dk2jk/ctcss/README.md

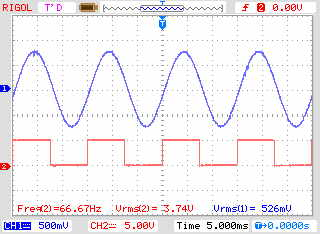
[picture p1: scope.jpg]
bild


# CTCSS - Tongenerator
als Update für ältere HAM-Radio VHF/UHF- Geräte.
Hardware: Arduino Mini-Pro ( 8 MHz / 3.3V ) 
Methode: Direkte Digitalen Synthese ( DDS )

# Ordner 'TS-811':
Es wird ein Selbstbau CTCSS-Modul zum Nachrüsten  in einen TS-811- Transceiver beschrieben, realisiert mit einem Arduino-Nano- Modul. Dabei wird die Direkte Digital Synthese  (DDS) verwendet.
