dk2jk/ctcss/SinusGeneratorArduino-0520.pdf

### Arduino Sinus-Generator nach der Direkten Digitalen Synthese ( DDS )

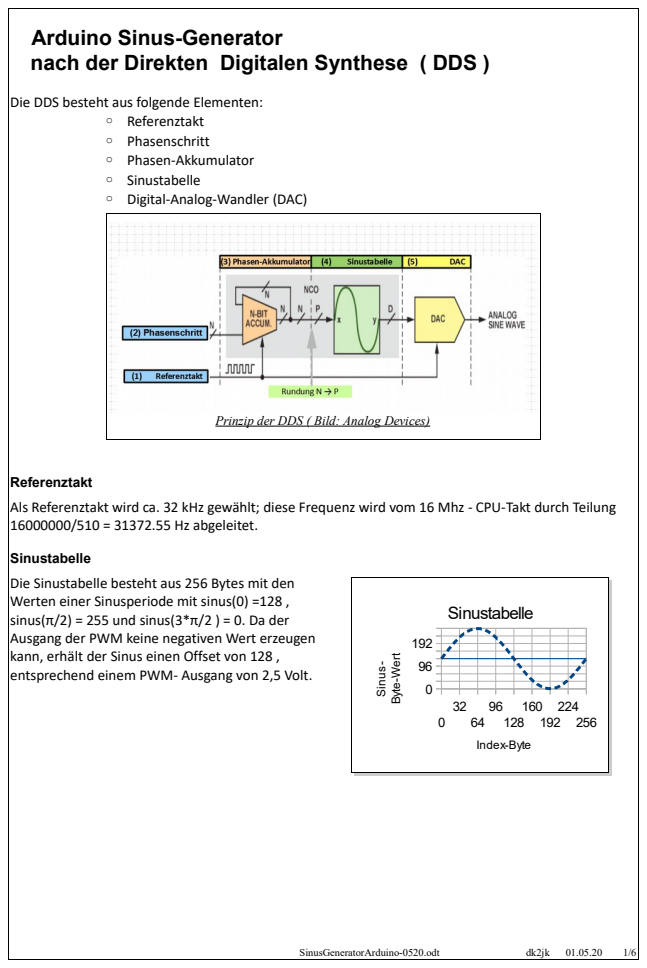
[picture p2: page 1]
SinusGeneratorArduino-0520.odt; Sinustabelle; Index-Byte; Sinus-; Byte-Wert

Die DDS besteht aus folgende Elementen:

◦ Referenztakt
◦ Phasenschritt
◦ Phasen-Akkumulator
◦ Sinustabelle
◦ Digital-Analog-Wandler (DAC)

Prinzip der DDS ( Bild: Analog Devices)

Referenztakt
Als Referenztakt wird ca. 32 kHz gewählt; diese Frequenz wird vom 16 Mhz - CPU-Takt durch Teilung
16000000/510 = 31372.55 Hz abgeleitet.

Sinustabelle
Die Sinustabelle besteht aus 256 Bytes mit den
Werten einer Sinusperiode mit sinus(0) =128 ,
sinus(π/2) = 255 und sinus(3*π/2 ) = 0. Da der
Ausgang der PWM keine negativen Wert erzeugen
kann, erhält der Sinus einen Offset von 128 ,
entsprechend einem PWM- Ausgang von 2,5 Volt.

Phasen-Akkumulator
Im Phasen-Akkumulator wird bei jedem Takt ein Phasenschritt-Wert aufaddiert. Die Phase wird dargestellt durch eine Zahl von 0 … 2**32-1 ( 32 Bit ). Das entspricht einem Datentyp 'unsigned long' .

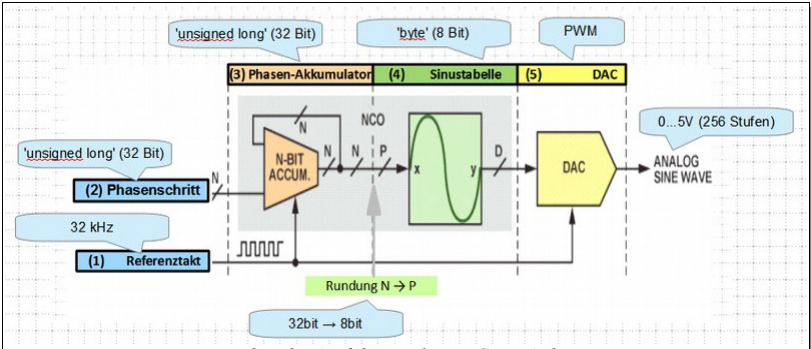
[picture p3: figure]

Wertezuordnung:
Phasen-Akkumulator N | Index in der Sinustabelle P | Grad | Winkel | sin(Winkel) | Ausgang D
0x00000000 | 0 | 0 | 0 | 0 | 127
0x40000000 | 64 | 90 | 0.5*pi | 1 | 255
0x80000000 | 128 | 180 | pi | 0 | 127
0xc0000000 | 192 | 270 | 1.5 *pi | -1 | 0
0xFFFFFFFF | 255 | <360 | <2*pi | <0 | <127
0x00000000 | 0 | 360 | 2*pi | 0 | 127

Die obersten 8 Bits (grau markiert) werden als Index in der Sinus-Tabelle verwendet( 0x00 = 1. Wert in der Tabelle , 0xFF= letzter Wert in der Tabelle ). Diese Rundung betrifft nur die Sinustabelle, der Phasen-Akkumulator behält seine 32-Bit-Auflösung.
Beim Überlauf des Phasen-Akkumulators von 0xFFFFFFFF auf 0x00000000 ergibt sich automatisch ein Sprung zum Beginn der Sinustabelle.
Mit dem Phasenschritt wird die Frequenz eingestellt: kleine Werte ergeben niedrige Frequenz , große Werte hohe Frequenz.
Es gilt folgende Formel:
f = ( Phasenschritt * Taktfrequenz ) / 2**32 Taktfrequenz = 31372.55 Hz
f = ( Phasenschritt* 31372.55 ) / 2**32

Aufgelöst nach Phasenschritt: Phasenschritt= 2**32* f / 31372.55)

SinusGeneratorArduino-0520.odt | dk2jk | 01.05.20 | 2/6

Praktische Ausführung der DDS mit Arduino

Anschauliche Darstellung
Das 'Digital Phase Wheel' demonstriert die Generierung des Sinus mit der DDS- Methode:

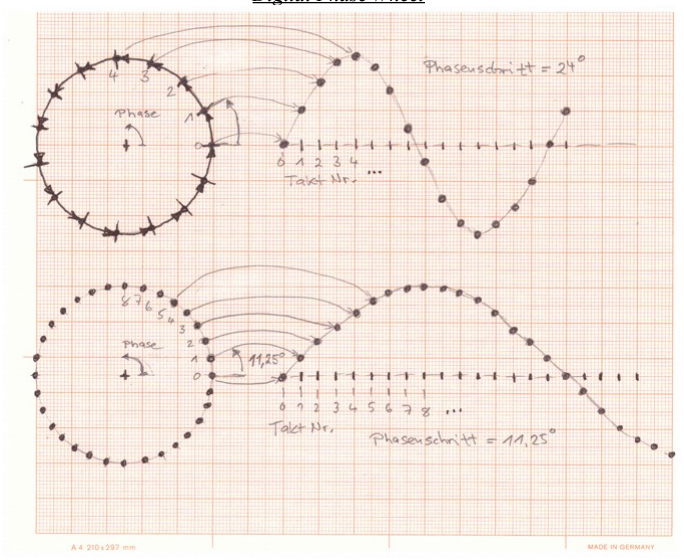
[picture p4: figure]

SinusGeneratorArduino-0520.odt | dk2jk | 01.05.20 | 3/6

Digital Phase Wheel

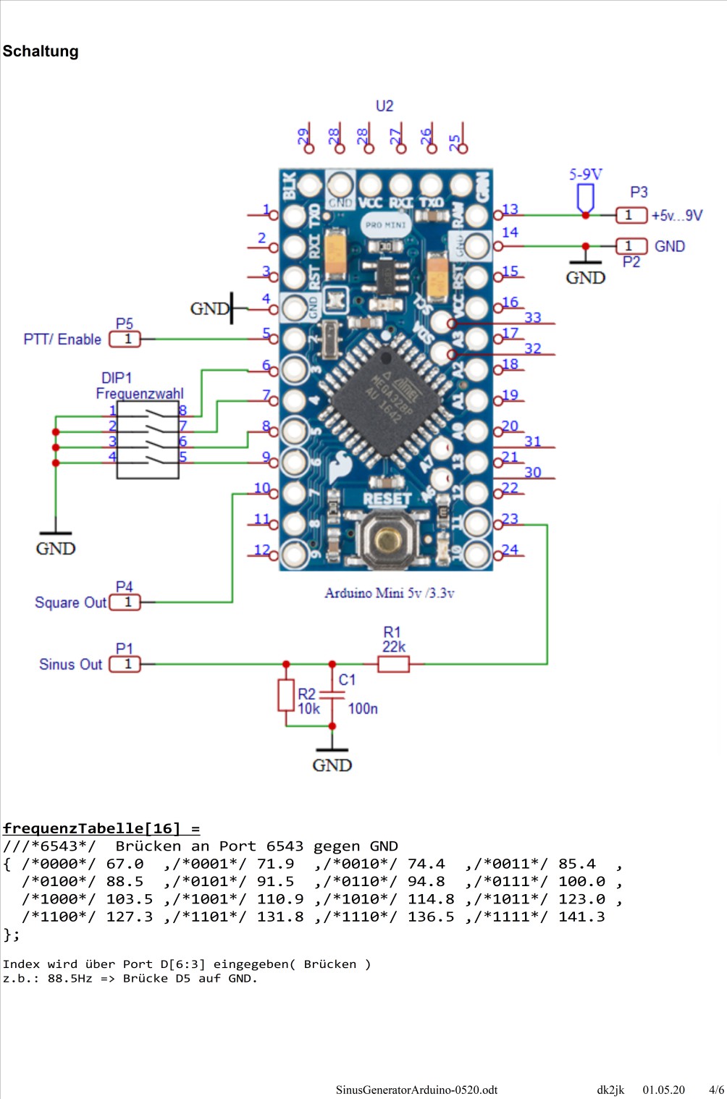
[picture p5: page 4]
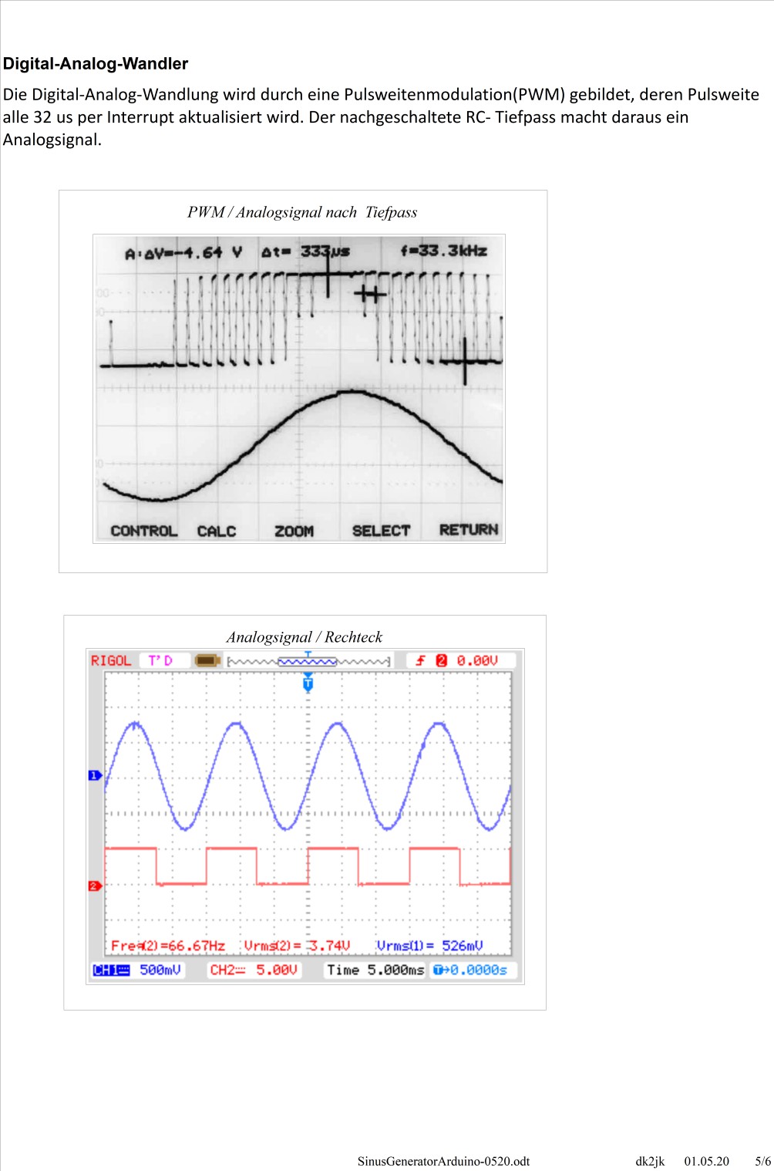
[picture p6: page 5]

Programm

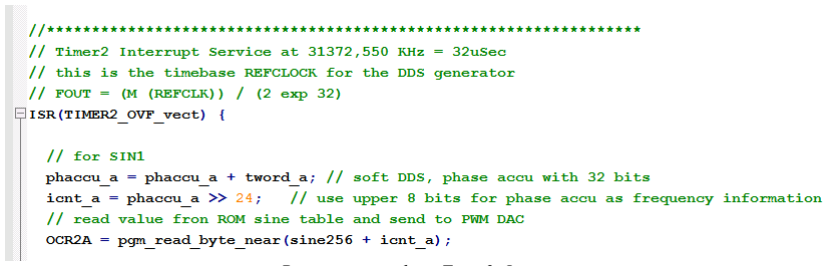
[picture p7: figure]
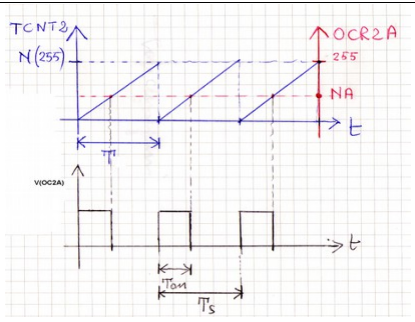
[picture p8: figure]

SinusGeneratorArduino-0520.odt | dk2jk | 01.05.20 | 6/6

Verhalten des PWM-Timer2 Arduino
[http://telpar.altervista.org/]

Programmausschnitt Timer2- Interrupt
