dk2jk/ctcss/TS-811/program/SimpleDDS-ts811.ino.pdf

C:\Users\dk2jk.000\Documents\Arduino\SimpleDDS-ts811\SimpleDDS-ts811.ino | Dienstag, 21. April 2020 19:24
1 | /*
2 | Simple DDS Signal Generator
3 | 2017/6/20 by morecat_lab
4 | based on
| http://interface.khm.de/index.php/lab/interfaces-advanced/arduino-dds-sinewave-gene
| rator/
5 | KHM 2009 / Martin Nawrath
6 | Kunsthochschule fuer Medien Koeln
7 | Academy of Media Arts Cologne
8 | */

9
10 | /***
11 | dk2jk 04 2020
12 | modifiziert
13 | nur ein ausgang
14 | CTCSS frequenzen wie MX-315 encoder
15 | Kanalwahl durch pins[10:5] entsprechend CX-315 pins [6:1]
16 | nach Frequenztabelle aus CX-315 Datenblatt "cx_315_v1.h"
17 | */

18
19 | #include "avr/pgmspace.h"
20 | #include "Arduino.h"
21 | #include "cx_315_v1.h" | //kanaltabelle wie MX-315 decoder
22 | #define PTT 2 | // CTCSS einschalten
23 | #define SINOUT 3 | // CTCSS ausgang
24 | #define TRIGGER A5 | // trigger sinus
25 | int | | kanal_pin[] | | | = | | { | | 5, | | 6, | | 7, | 8, | | 9, | 10}; | // CTCSS Kanal Code
26 | #define LED 13

27
28 | #include "sinus.h" | // sinus[]

29
30 | #define cbi(sfr, bit) (_SFR_BYTE(sfr) &= ~_BV(bit))
31 | #define sbi(sfr, bit) (_SFR_BYTE(sfr) |= _BV(bit))
32 | #define REFCLK (31376.6)

33
34 | // fuer interrupt routine volatile !
35 | volatile | | unsigned | | long | | phase_accu;
36 | volatile | | unsigned | | long | | phase_increment;
37 | volatile | | byte | | phase_index;

38
39
40 | static | | inline | | void | | disable_timer0() | | | {
41 | | cbi | | (TIMSK0, | | | | TOIE0);
42 | | // disable Timer0 !!! delay() is now not available
43 | | // damit 1ms -IRQ nicht stoert !!!
44 | }
45 | static | | inline | | void | | enable_timer() | | | {
46 | | sbi | | (TIMSK2, | | | | TOIE2);
47 | }
48 | static | | inline | | void | | disable_timer() | | | {
49 | | cbi | | (TIMSK2, | | | | TOIE2);
50 | }

51
52 | byte | | liesKanal()
53 | { | | byte | | y | | = | | 0;
54 | | int | | i;
55 | | for | | (i | | | = | | 5; | | i | | >= | 0; | i--)
56 | | { | | y | | = | | y | | + | (digitalRead(kanal_pin[i]) | | | | | << | i);
57 | | }
58 | | return | | (y | | | & | | 0x3f);
59 | }

60
61 | float | | code_to_frequenz(byte | | | | code)
62 | { | | // in frequenztabelle nach code suchen
63 | | int | | i;
64 | | bool | | gefunden | | = | | false;
65 | | for | | (i | | | = | | 0; | | i | | < | TABELLENLAENGE; | i++)
66 | | { | | if | | ( | | frequenztabelle[i].code | | | | | == | code)
67 | | { | | gefunden | | = | | true;
68 | | break;

71 | return | gefunden | ? | frequenztabelle[i].fq | : | 1000.0;

73
74 | unsigned | | long | | tick(int | | | | i)
75 | { | | return | | pow(2, | | | | | 32) | | | * | | code_to_frequenz(i) | | | | / | | REFCLK;
76 | }

77
78 | void | | setup_SineFreq(int | | | | fq_index) | | | {
79 | | disable_timer();
80 | | phase_increment | | = | | tick(fq_index);
81 | | phase_accu | | = | | 0;
82 | | enable_timer();
83 | }

84
85 | void | | Setup_timer2() | | | {
86 | | // set prscaler to 1, PWM mode to phase correct PWM, 16000000/510 = 31372.55 Hz
| clock
87 | | TCCR2A | | = | | (1 | | | << | | COM2A1) | | | | | | (0 | | << | | COM2A0) | | | | ( | 1 | << | COM2B1) | | | ( | 0 | << | COM2B0) | | | ( | 0 | <<
| WGM21) | | | | | | ( | | 1 | | << | | WGM20);
88 | | // Timer2 Clock Prescaler to : 1 => 16000000/510 = 31372.55 Hz clock
89 | | TCCR2B | | = | | (0 | | | << | | WGM22) | | | | | | (0 | | << | | CS22) | | | | ( | 0 | << | CS21) | | | ( | 1 | << | CS20);
90 | }

91
92 | // Timer2 Interrupt Service at 31372,550 KHz = 32uSec
93 | ISR(TIMER2_OVF_vect) | | | | | {
94 | | phase_accu | | = | | phase_accu | | + | | phase_increment; | | | // soft DDS, phase accu with 32 bits
95 | | phase_index | | = | | phase_accu | | >> | | 24; | | | // use upper 8 bits for phase accu as frequency
| information
96 | | // read value fron ROM sine table and send to PWM DAC
97 | | OCR2B | | = | | pgm_read_byte_near(sinus | | | | + | | phase_index);
98 | | if | | (OCR2B | | | < | | sinus[0])
99 | | { | | // output digital by PWM info // compare a = 128...255
100 | | digitalWrite(TRIGGER, | | | | | HIGH);
101 | | } | | else | | {
102 | | digitalWrite(TRIGGER, | | | | | LOW);
103 | | }
104 | }

105
106 | void | | setup()
107 | { | | pinMode(LED, | | | | | OUTPUT);
108 | | pinMode(SINOUT, | | | | | OUTPUT);
109 | | pinMode(TRIGGER, | | | | | OUTPUT);
110 | | pinMode(PTT, | | | | | INPUT); | | | // high active
111 | | for | | (int | | | i | | = | | 0; | | | i | | < | 6; | | | i++)
112 | | { | | pinMode(kanal_pin[i], | | | | | | | INPUT_PULLUP);
113 | | }
114 | | disable_timer0();
115 | | Setup_timer2();
116 | | setup_SineFreq(63);
117 | }

118
119 | void | | loop() | | | {
120 | | static | | byte | | alt | | = | | 0;
121 | | static | | byte | | neu | | = | | 1;
122 | | static | | bool | | en_alt | | = | | true;
123 | | static | | bool | | en_neu | | = | | false;
124 | | neu | | = | | liesKanal();
125 | | if | | ( | | neu | | == | | alt)
126 | | { | | // nix zu tun
127 | | }
128 | | else
129 | | { | | setup_SineFreq( | | | neu);
130 | | alt | | = | | neu;
131 | | }
132 | | en_neu | | = | | digitalRead(PTT);
133 | | if | | ( | | en_neu | | == | | en_alt)
134 | | { | | //nix zu tun
136 | else
137 | { | en_alt | = | en_neu;

138 | if | (en_neu | == | 0)
139 | { | disable_timer();
141 | | if | ( | en_neu | == | 1)
142 | | { | enable_timer();
143 | | }
144 | | }
145 | }

146
