dk2jk/ctcss/TS-811/doc/ctcss_scope.jpg

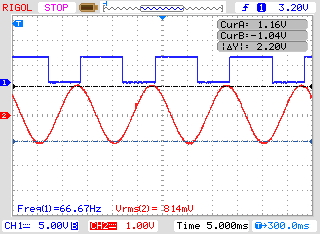
TS-811/doc/ctcss_scope.jpg
