dk2jk/ctcss/TS-811/doc/TS-811-Platineneinbau.jpg

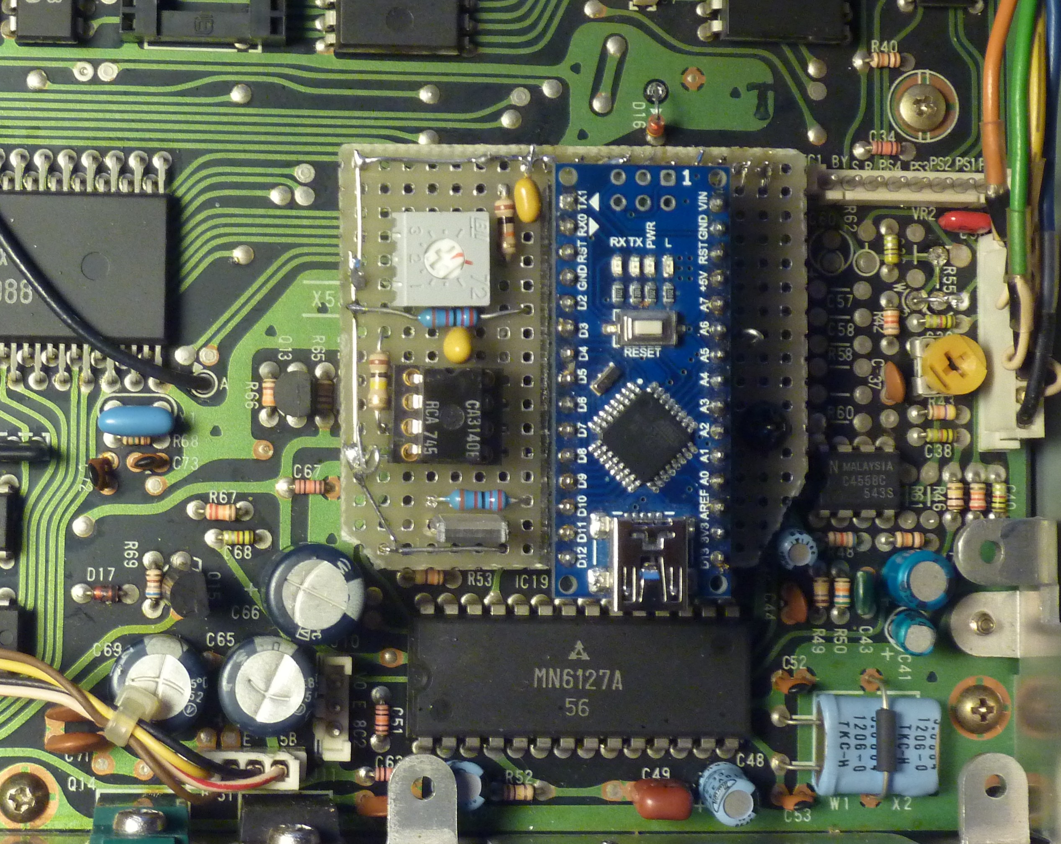
TS-811/doc/TS-811-Platineneinbau.jpg
