dk2jk/ctcss/TS-811/doc/TU-5.png

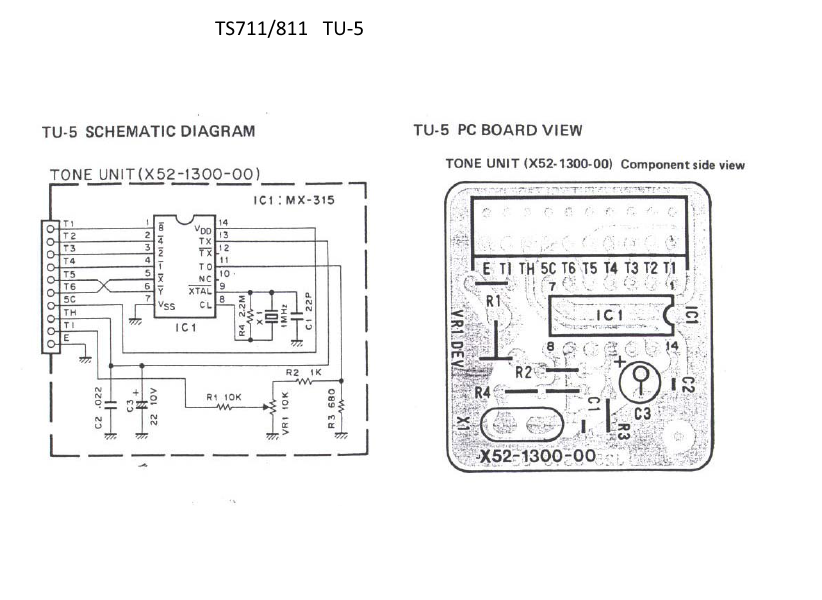
TS-811/doc/TU-5.png
