dk2jk/ctcss/TS-811/doc/Schematic_sinus2_2020-04-28_15-29-29.pdf

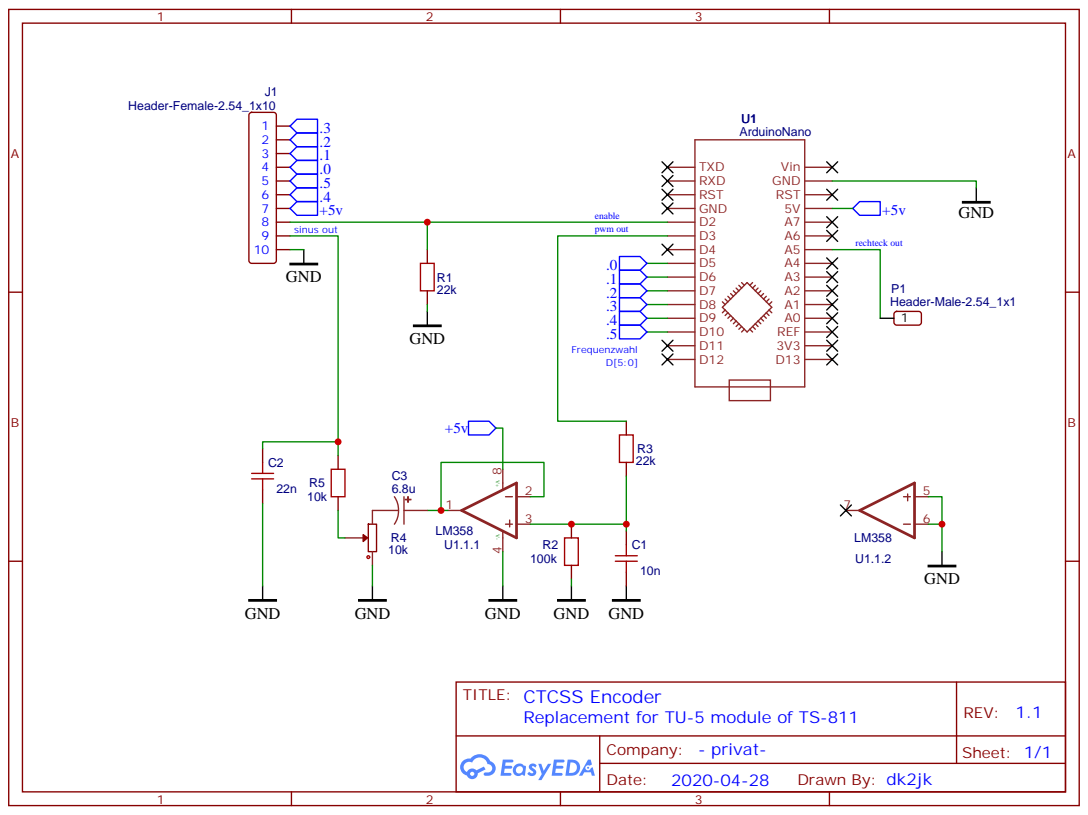
[picture p12: page 1]

Replacement for TU-5 module of TS-811
