dk2jk/ctcss/TS-811/program/cx_315_v1.h

/********** cx_315_v1.h ****/

struct s_frequenztabelle{
 float fq; byte code; };
#define TABELLENLAENGE 41
s_frequenztabelle frequenztabelle[TABELLENLAENGE]= {
//fq,	i, 	    //[5....0] bin
{67.0,	63},	// 111111
{69.3,	57},	// 111001
{71.9,	31},	// 011111
{74.4,	62},	// 111110
{77.0,	15},	// 001111
{79.7,	61},	// 111101
{82.5,	30},	// 011110
{85.4,	60},	// 111100
{88.5,	14},	// 001110
{91.5,	59},	// 111011
{94.8,	29},	// 011101
{97.4,	58},	// 111010
{100.0,	13},	// 001101
{103.5,	28},	// 011100
{107.2,	12},	// 001100
{110.9,	27},	// 011011
{114.8,	11},	// 001011
{118.8,	26},	// 011010
{123.0,	10},	// 001010
{127.3,	25},	// 011001
{131.8,	9},	// 001001
{136.5,	24},	// 011000
{141.3,	8},	// 001000
{146.2,	23},	// 010111
{151.4,	7},	// 000111
{156.7,	22},	// 010110
{162.2,	6},	// 000110
{167.9,	21},	// 010101
{173.8,	5},	// 000101
{179.9,	20},	// 010100
{186.2,	4},	// 000100
{192.8,	19},	// 010011
{203.5,	3},	// 000011
{206.5,	56},	// 111000
{210.7,	18},	// 010010
{218.1,	2},	// 000010
{225.7,	17},	// 010001
{233.6,	1},	// 000001
{241.8,	16},	// 010000
{250.3,	0},	// 000000
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
};
