dk2jk/ctcss/TS-811/program/sinus.h

//**** sinus.h ****
//**** generiert durch 'gentab.py
//**** Sat Apr 25 13:10:10 2020'
#define SINUS_SIZE 256
const unsigned char sinus[ SINUS_SIZE ] PROGMEM = {
102,103,105,107,109,110,112,114,115,117,119,121,122,124,126,127,
129,131,132,134,135,137,138,140,141,143,144,146,147,148,150,151,
152,153,155,156,157,158,159,160,161,162,163,164,165,166,166,167,
168,168,169,170,170,171,171,171,172,172,172,173,173,173,173,173,
173,173,173,173,173,173,172,172,172,171,171,171,170,170,169,168,
168,167,166,166,165,164,163,162,161,160,159,158,157,156,155,153,
152,151,150,148,147,146,144,143,141,140,138,137,135,134,132,131,
129,127,126,124,122,121,119,117,115,114,112,110,109,107,105,103,
102,101,99,97,95,94,92,90,89,87,85,83,82,80,78,77,
75,73,72,70,69,67,66,64,63,61,60,58,57,56,54,53,
52,51,49,48,47,46,45,44,43,42,41,40,39,38,38,37,
36,36,35,34,34,33,33,33,32,32,32,31,31,31,31,31,
31,31,31,31,31,31,32,32,32,33,33,33,34,34,35,36,
36,37,38,38,39,40,41,42,43,44,45,46,47,48,49,51,
52,53,54,56,57,58,60,61,63,64,66,67,69,70,72,73,
75,77,78,80,82,83,85,87,89,90,92,94,95,97,99,101,
 };
