dk2jk/ctcss/(commit log)

2020-04-16 Add files via upload
    arduino ino file
2020-04-25 Create schematic
2020-04-25 Create arduino
2022-06-28 arduino sketches
